MilKris666/DCS-AH-64-KDU-Keyboard-Display-Unit/README.md

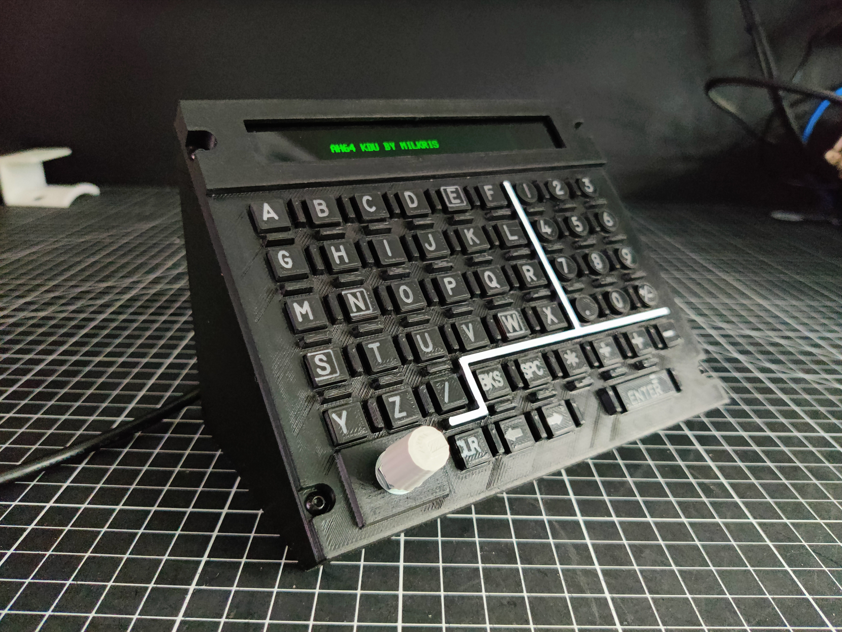
[picture p1: KDU.jpg]


Demo: https://youtube.com/shorts/2huMgZh5P64

Complete CP/G Frontpanel: https://www.youtube.com/shorts/GwC2EZVeXsk

# This is now Arduino-only KDU! No BBI64 board is required!

# The code has been completely redesigned. It constantly checks whether you are in the pilot or co-pilot/gunner position, and the controls are automatically assigned accordingly.

Here is my KDU (Keyboard Display Unit) for the DCS AH-64D Apache. The project includes files for 3D printing, laser engraving of the button labels, and, of course, the Arduino code.

I engraved the labels with a laser, but I've added another version of the buttons where the labels are raised so they can be printed directly with a 3D printer.

I used an Arduino MEGA 2560 and a SSD1322 SPI 256x64 green pixels OLED (4-Wire SPI Interface).

Make sure to use the latest version of DCS-BIOS Skunkworks.

**RTFM** -- read the **How-To.pdf** !!
Download the How-To.pdf to access the links!

**LICENSE:**
Creative Commons Attribution-NonCommercial 4.0 International Public License

**My projects have been downloaded thousands of times in the past. Providing the files and creating a guide is very time-consuming. Since no one is willing to make even a small donation, I have decided to offer the 3D files only for a small fee from now on.** https://cults3d.com/de/modell-3d/gadget/ah-64d-kdu-keyboard-display-unit
