MilKris666/DCS-AH-64-KDU-Keyboard-Display-Unit/KDU2.jpg

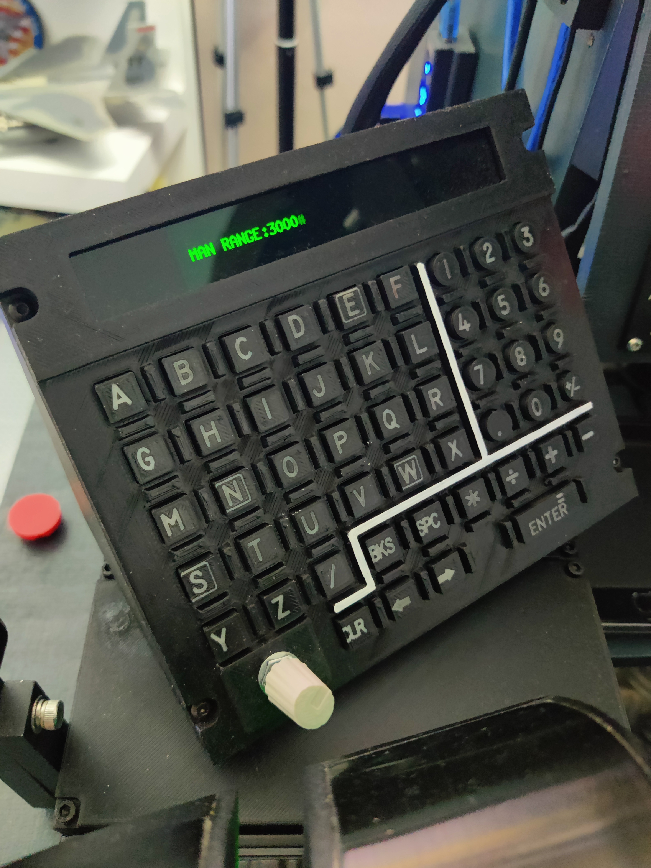
KDU2.jpg
