MilKris666/DCS-AH-64-KDU-Keyboard-Display-Unit/How-To_v6.pdf

# MilKris‘ Keyboard Display Unit (KDU) for the DCS AH64D Apache

This version is for an Arduino-only KDU. No BBI64 board is required!

DISCLAIMER: I’m not a professional maker! It’s not perfect, but it works and I’m fine with the result. Here and there, some filing, drilling, and gluing mightbe necessary...

My projects have been downloaded thousands of times in the past. Providing the files and creating a guide is very time-consuming. Since no one is willing to make even a small donation, I have decided to offer the 3D files only for a small fee from now on. https://cults3d.com/de/modell-3d/gadget/ah-64d-kdu-keyboarddisplay-unit (https://cults3d.com/de/modell-3d/gadget/ah-64d-kdu-keyboard-display-unit)

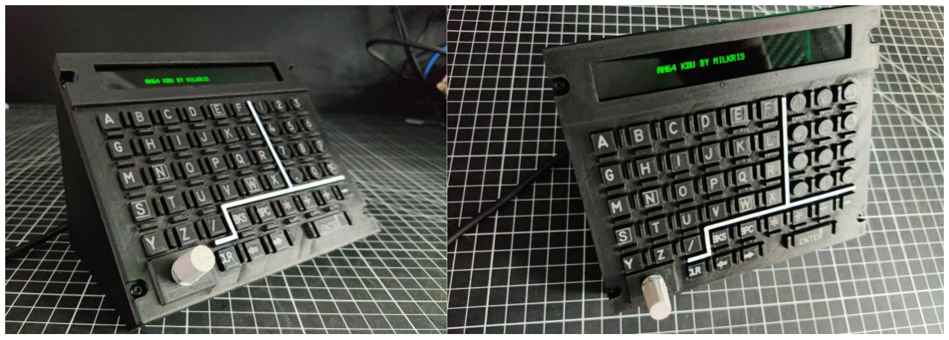
[picture p3: figure]

Here is my KDU (Keyboard Display Unit) for the DCS AH-64D Apache. The project includes files for 3D printing, laser engraving of the button labels, and, of course, the Arduino code.

I engraved the labels with a laser, but I've added another version of the buttons where the labels are raised so they can be printed directly with a 3D printer.

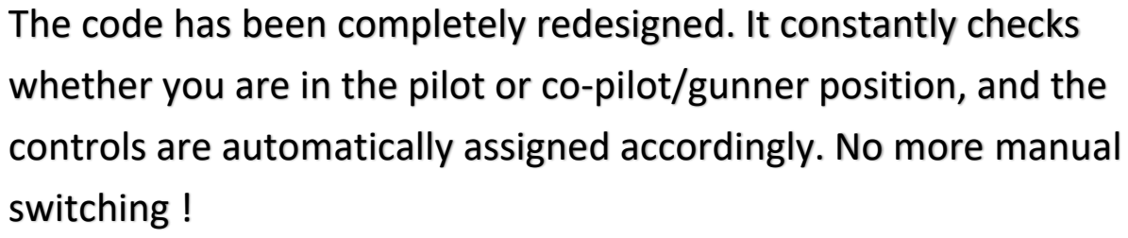
[picture p4: figure]
switching !

## The code has been completely redesigned. It constantly checks whether you are in the pilot or co-pilot/gunner position, and the controls are automatically assigned accordingly. No more manual

You need to flash my code onto an Arduino MEGA. Here is my code: https://github.com/MilKris666/DCS-AH-64-KDU-Keyboard-Display-Unit/blob/main/AH64_KDU_Display_4.ino (https://github.com/MilKris666/DCS-AH-64-KDU-Keyboard-Display-Unit/blob/main/AH64_KDU_Display_4.ino)

If you have no idea how to set up DCS BIOS or upload code to an Arduino, make sure to check out this tutorial by Hornetsnest! https://www.youtube.com/watch?v=ZGoG54vNyyI

# Part list:

50x 6x6x4,3mm Tactile Switches: https://www.amazon.de/Youmile-100PACK-Schalter-Momentan-Tactile/dp/B07XWXV1TS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 (https://www.amazon.de/Youmile-100PACK-Schalter-Momentan-Tactile/dp/B07XWXV1TS)

1x Arduino MEGA 2560 R3 : https://www.amazon.de/Mega-2560-R3-Entwicklungsboard-Kompatibel-Verbessert-Stromversorgung/dp/B0CT8QC1FF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 tQ72-
iIjSGfOJfFYUHD5PuFidfUraswgxqMx9MXz78wgLmiDwant_JbnZ_NY0oDgzMvK7E0oYrZU2uOg3ro92_N WChiTh_zJs_pr4imTFr1d7__L1te9fTxnzzMvXxXB0SGgSXyXJv_Yy8J3jT-kYErX8UN9M0W-VXlGYDmsd6MggJdTmIvVJTZc8do-13Y3U.Af5D_nItbnqtugG2HcTlGeUPVsNloIwUBOOvNPLbqow&dib_tag=se&keywords=arduino+mega +2560&qid=1771854082&sr=8-1 (https://www.amazon.de/Mega-2560-R3-Entwicklungsboard-Kompatibel-Verbessert-Stromversorgung/dp/B0CT8QC1FF)

1x 3.2” SSD1322 SPI 256x64 green pixels OLED (4-Wire SPI Interface): https://www.buydisplay.com/green-3-2-inch-arduino-raspberry-pi-oled-display-module-256x64-spi

1x Potentiometer RV097NS 6mm https://www.amazon.de/s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 (https://www.amazon.de/s?k=RV097NS+Potentiometer&__mk_de_DE=%C3%85M%C3%85%C5%BD%C3%95%C3%91)

Optional if you want backlit lettering
2x green LED Filament:
https://www.amazon.de/LISOCLU-Flexibles-LED-Perlendiode-Lichtzubeh%C3%B6rflexibles/dp/B0DGQ17CBC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 HM9HJDjPLyRUn3fuej3MXhCezRBJt5IEfB8FyzoDpritIx1rgfosUh3JGaqRmsI-P9MpDt8EH45LEnDPwRF5B0AaX2_3dn745xScEQbqDoa2JaSXo75MmcI5gKzkLawPMQL7N3aBiqfc3yb2Bxg3.3z_NiMQb6Ro_yU0_UNk8SAhppodXVby1FKetAXP1tPI&dib_tag=se&keywords=3V%2 BLED-Filament%2B110mm%2BRot%2BGr%C3%BCn%2BBlau%2B2700K%2BFlexible%2BFilamentlampe&qid=1739521114&sr=8-3&th=1 (https://www.amazon.de/LISOCLU-Flexibles-LED-Perlendiode-Lichtzubeh%C3%B6r-flexibles/dp/B0DGQ17CBC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)

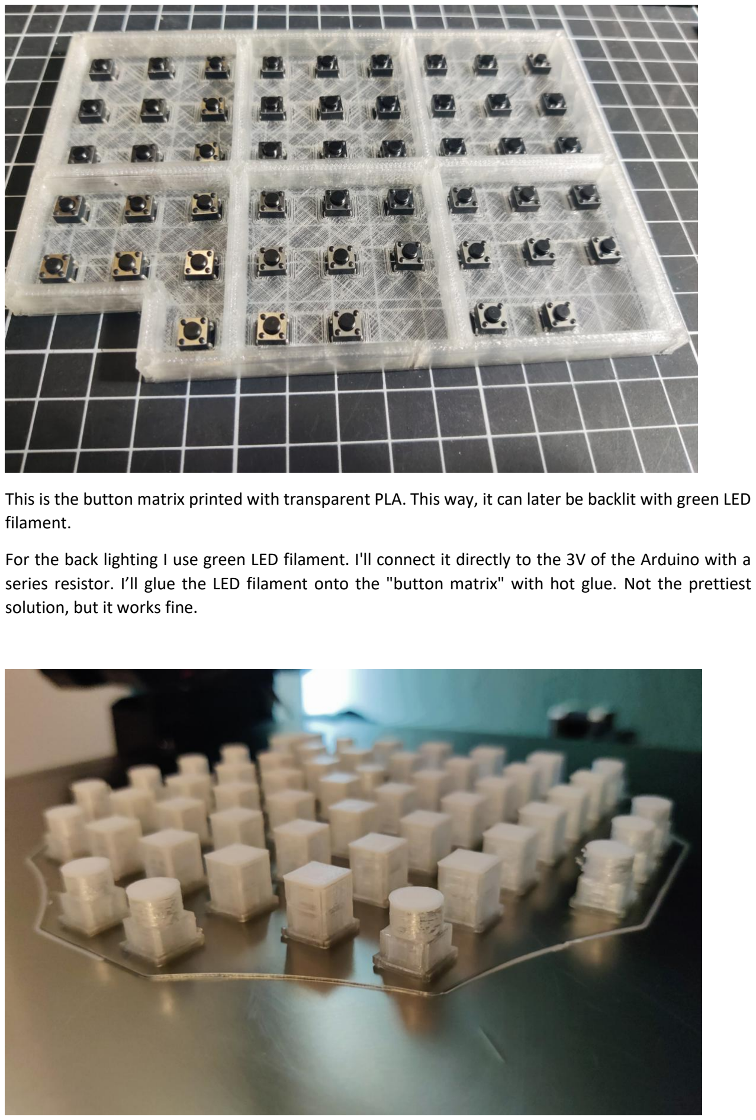
[picture p5: page 3]

This is the button matrix printed with transparent PLA. This way, it can later be backlit with green LED filament.

For the back lighting I use green LED filament. I'll connect it directly to the 3V of the Arduino with a series resistor. I’ll glue the LED filament onto the "button matrix" with hot glue. Not the prettiest solution, but it works fine.

The buttons were also printed with transparent PLA. The top three layers were printed with white PLA, making them ideal for backlighting. The buttons are then spray-painted with black acrylic lacquer from a can and can be engraved with a diode laser.

If laser engraving is not an option for you, you can 3D print the buttons with raised lettering. In this case, you should print the buttons with black PLA and use white PLA only for the top layers.

If you don’t have a dual-extruder 3D printer, you can set up a Post-Process script in you slicer ("Pause at Layer Height") and manually switch the filament.

Alternatively, you can print the buttons entirely in black and carefully paint the lettering white using a white marker (e.g., Edding). To make the finish more durable, you should seal everything with a clear coat.

You'll need to experiment a bit to find out which method works best for you.

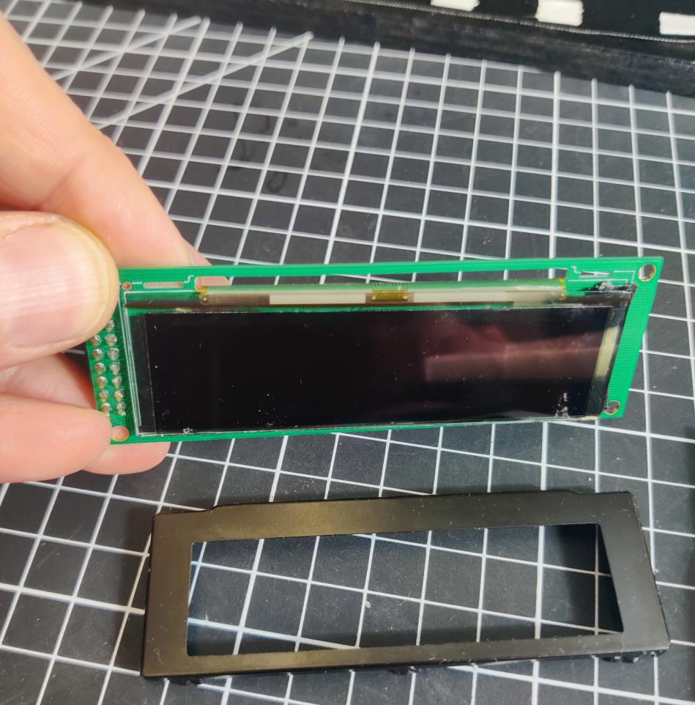
[picture p6: figure]

Remove the frame from the OLED Display.

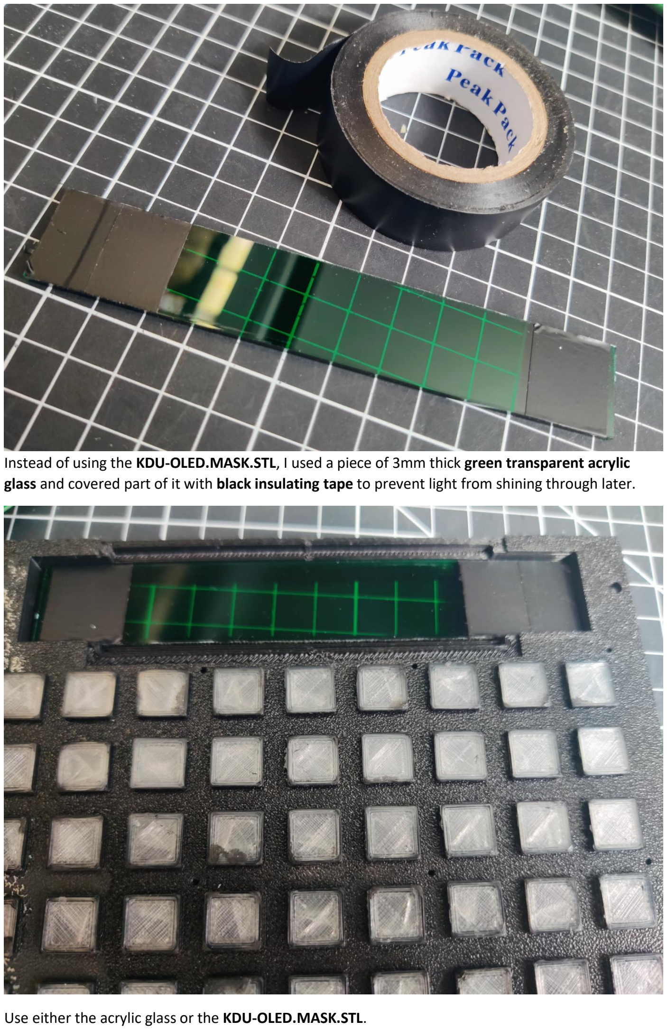
[picture p7: page 5]

Instead of using the KDU-OLED.MASK.STL, I used a piece of 3mm thick green transparent acrylic glass and covered part of it with black insulating tape to prevent light from shining through later.

Use either the acrylic glass or the KDU-OLED.MASK.STL.

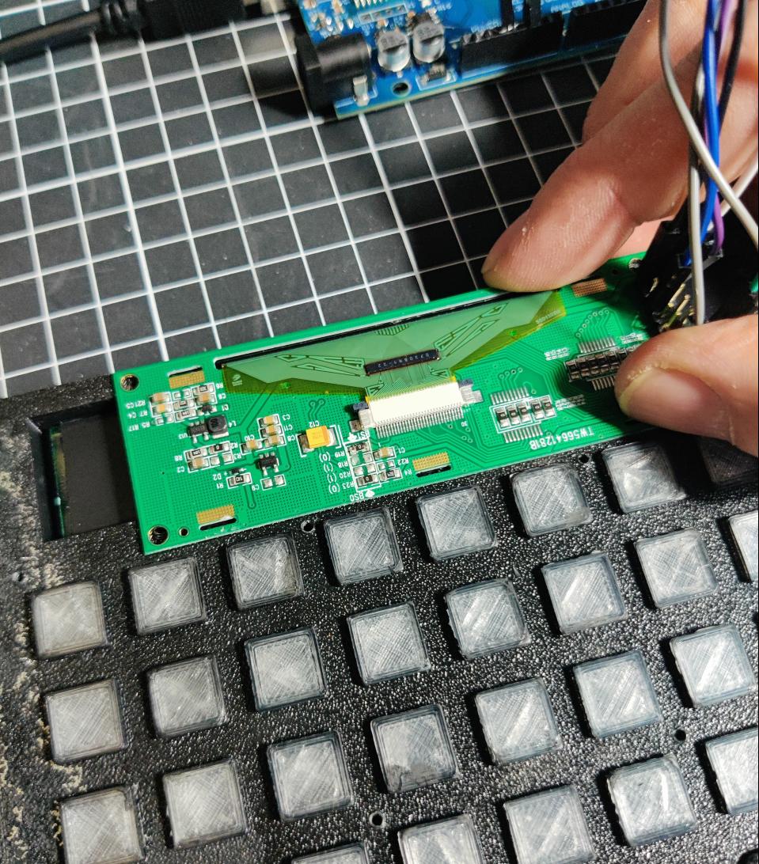
[picture p8: figure]

The OLED is simply inserted and secured by the button matrix. To ensure everything fits together later, the OLED pins need to be bent significantly. Even better, solder the wires instead of using Dupont connectors.

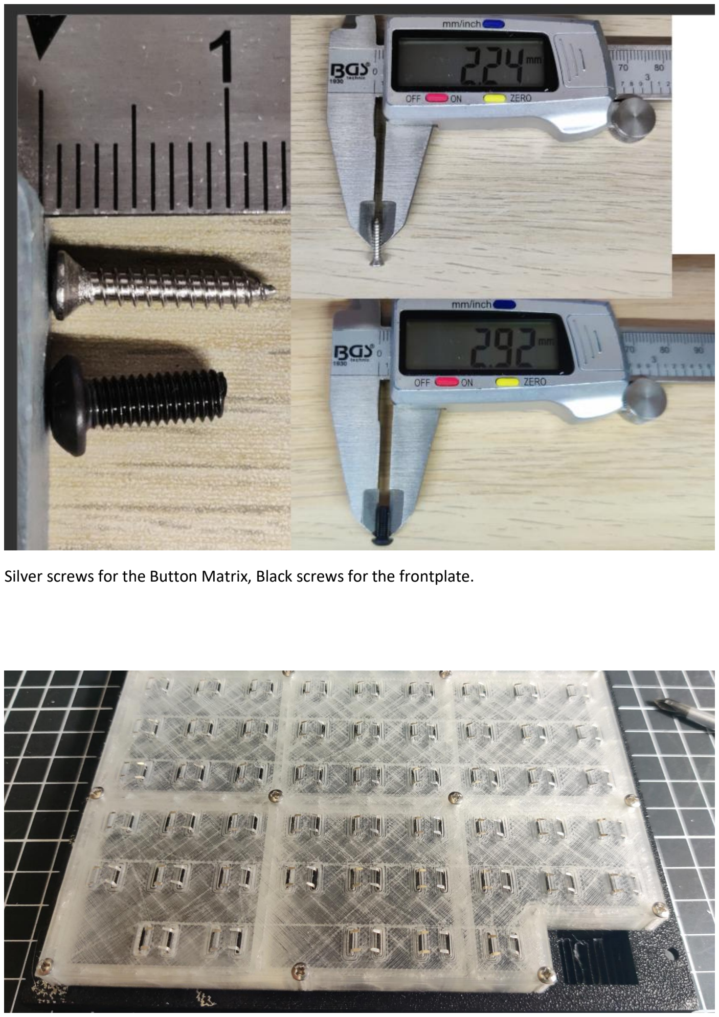
[picture p9: page 7]

Silver screws for the Button Matrix, Black screws for the frontplate.

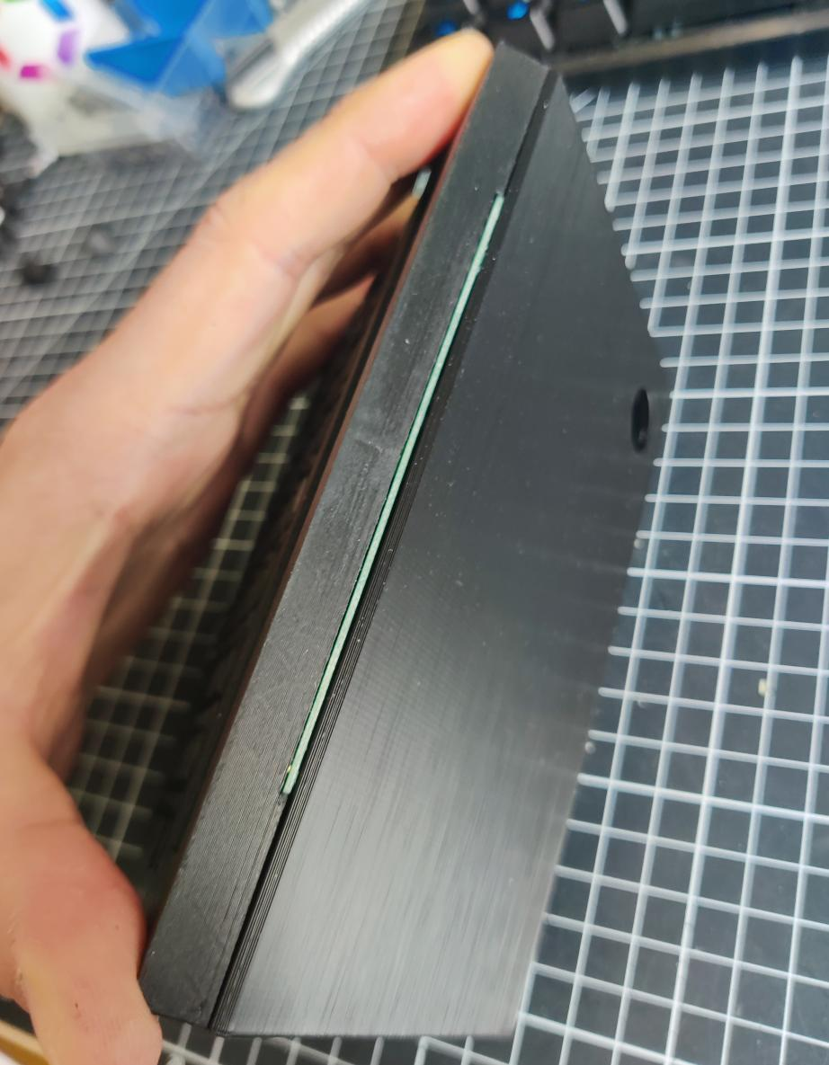
[picture p10: figure]

### Simply connect the OLED display pin by pin to the Arduino, as shown in the diagram. The seven required connections are highlighted with colored dashed lines

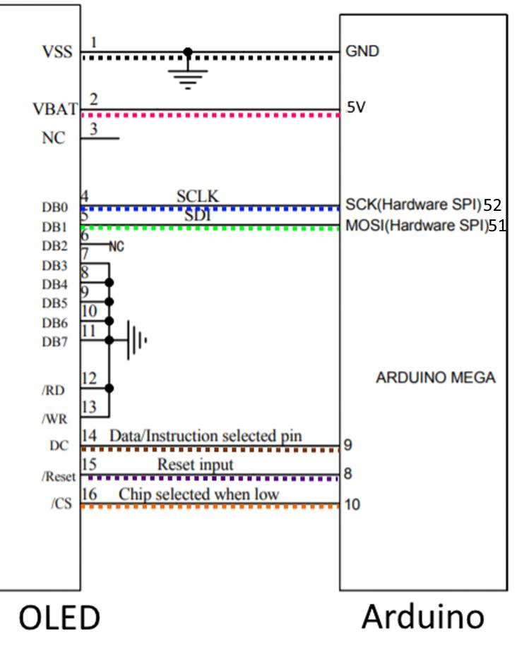
[picture p11: figure]

WARNING! Some SSD1322 OLEDs arrive in I²C mode instead of SPI. To enable SPI mode, the SMD resistors must be configured as shown in the image below:

- R5 (0) → closed
- R6 (1) → open
- R7 (1) → open
- R8 (0) → closed

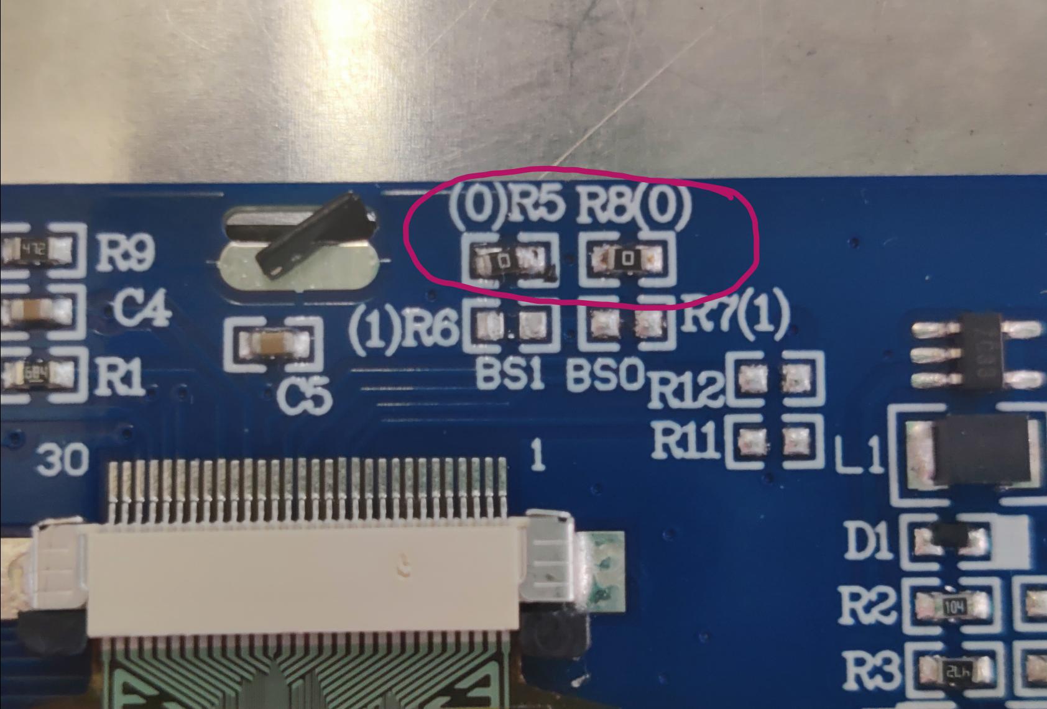
[picture p12: figure]

# WIRING INFO

Display Pin | | Arduino Mega Pin
VCC | | 5V (oder 3.3V je nach Modul!)
GND | | GND
SCK / CLK | 52
MOSI / DIN | 51
CS | 10
DC | 9
RST | 8
Poti | Pin | PLT | CPG
pot_01 | A0 | PLT_KU_BRT | CPG_KU_BRT
Switch | Pin | PLT Controlname | CPG Controlname
switch2_01 | D24 | PLT_KU_0 | CPG_KU_0
switch2_02 | D34 | PLT_KU_1 | CPG_KU_1
switch2_03 | D35 | PLT_KU_2 | CPG_KU_2
switch2_04 | D36 | PLT_KU_3 | CPG_KU_3
switch2_05 | D43 | PLT_KU_4 | CPG_KU_4
switch2_06 | D44 | PLT_KU_5 | CPG_KU_5
switch2_07 | D45 | PLT_KU_6 | CPG_KU_6
switch2_08 | A2 | PLT_KU_7 | CPG_KU_7
switch2_09 | A5 | PLT_KU_8 | CPG_KU_8
switch2_10 | D31 | PLT_KU_9 | CPG_KU_9
switch2_11 | D14 | PLT_KU_A | CPG_KU_A
switch2_12 | A1 | PLT_KU_B | CPG_KU_B
switch2_13 | D12 | PLT_KU_C | CPG_KU_C
switch2_14 | D11 | PLT_KU_D | CPG_KU_D
switch2_15 | D32 | PLT_KU_E | CPG_KU_E
switch2_16 | D33 | PLT_KU_F | CPG_KU_F
switch2_17 | D37 | PLT_KU_G | CPG_KU_G
switch2_18 | D38 | PLT_KU_H | CPG_KU_H
switch2_19 | D39 | PLT_KU_I | CPG_KU_I
switch2_20 | D40 | PLT_KU_J | CPG_KU_J
switch2_21 | D41 | PLT_KU_K | CPG_KU_K
switch2_22 | D42 | PLT_KU_L | CPG_KU_L
switch2_23 | D46 | PLT_KU_M | CPG_KU_M
switch2_24 | D47 | PLT_KU_N | CPG_KU_N

Switch | Pin | PLT Controlname | CPG Controlname
switch2_25 | D48 | PLT_KU_O | CPG_KU_O
switch2_26 | D49 | PLT_KU_P | CPG_KU_P
switch2_27 | A3 | PLT_KU_Q | CPG_KU_Q
switch2_28 | A4 | PLT_KU_R | CPG_KU_R
switch2_29 | D30 | PLT_KU_S | CPG_KU_S
switch2_30 | D29 | PLT_KU_T | CPG_KU_T
switch2_31 | D28 | PLT_KU_U | CPG_KU_U
switch2_32 | D27 | PLT_KU_V | CPG_KU_V
switch2_33 | D26 | PLT_KU_W | CPG_KU_W
switch2_34 | D25 | PLT_KU_X | CPG_KU_X
switch2_35 | A7 | PLT_KU_Y | CPG_KU_Y
switch2_36 | A8 | PLT_KU_Z | CPG_KU_Z
switch2_37 | D18 | PLT_KU_LEFT | CPG_KU_LEFT
switch2_38 | D17 | PLT_KU_RIGHT | CPG_KU_RIGHT
switch2_39 | D7 | PLT_KU_BKS | CPG_KU_BKS
switch2_40 | D19 | PLT_KU_CLR | CPG_KU_CLR
switch2_41 | D4 | PLT_KU_DIV | CPG_KU_DIV
switch2_42 | D23 | PLT_KU_DOT | CPG_KU_DOT
switch2_43 | D16 | PLT_KU_ENT | CPG_KU_ENT
switch2_44 | D2 | PLT_KU_MINUS | CPG_KU_MINUS
switch2_45 | D5 | PLT_KU_MULTI | CPG_KU_MULTI
switch2_46 | D3 | PLT_KU_PLUS | CPG_KU_PLUS
switch2_47 | D22 | PLT_KU_SIGN | CPG_KU_SIGN
switch2_48 | A9 | PLT_KU_SLASH | CPG_KU_SLASH
switch2_49 | D6 | PLT_KU_SPC | CPG_KU_SPC

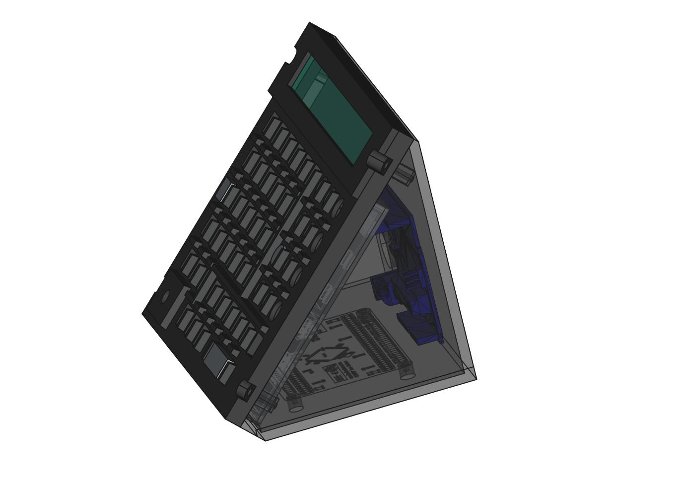
[picture p13: figure]
