MilKris666/DCS-AH-64-KDU-Keyboard-Display-Unit/How-To.pdf

# MilKris‘ Keyboard Display Unit (KDU) for the DCS AH64D Apache

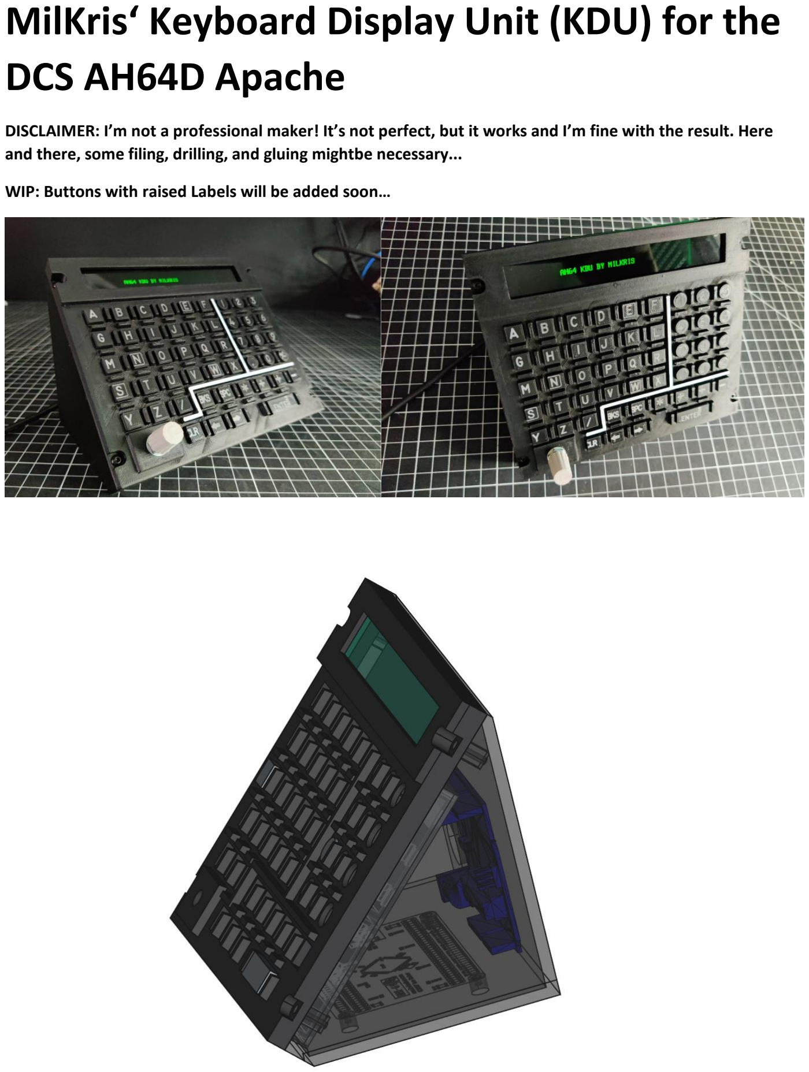
[picture p14: page 1]

DISCLAIMER: I’m not a professional maker! It’s not perfect, but it works and I’m fine with the result. Here and there, some filing, drilling, and gluing mightbe necessary...

WIP: Buttons with raised Labels will be added soon…

You need:

50x 6x6x4,3mm Tactile Switches: https://www.amazon.de/Youmile-100PACK-Schalter-Momentan-Tactile/dp/B07XWXV1TS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 (https://www.amazon.de/Youmile-100PACK-Schalter-Momentan-Tactile/dp/B07XWXV1TS)

1x Arduino UNO: https://www.amazon.de/Entwicklungskarten-Mikrocontrollern-Bingheelektronische-Kompatibel/dp/B0DKX16PJT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 qid=1739455679&sr=8-17 (https://www.amazon.de/Entwicklungskarten-Mikrocontrollern-Binghe-elektronische-Kompatibel/dp/B0DKX16PJT)

1x SSD1322 SPI OLED: https://www.amazon.de/OLED-Display-SSD1322-Grafik-LCD-Modul-Parallel-L%C3%B6tstift-wei%C3%9F/dp/B0DQ52MRX1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 (https://www.amazon.de/OLED-Display-SSD1322-Grafik-LCD-Modul-Parallel-L%C3%B6tstift-wei%C3%9F/dp/B0DQ52MRX1)

1x Rotary Encoder: https://www.amazon.de/Drehgeber-Drehwinkelgeber-Digital-Potentiometer-Encoder/dp/B0B63YN466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 HU2K8SeNbNwpCsJ6Vg5nMULRNwRJ6Uxj7ICXr25UlcgFOb-3piOo0v1sLLtAed3bi3OQrqieZ96s0bh6Isc40fqSFs0EnRit2HuflkEqfBKdsaTWKNQpdv2MtKj7ySbaM5aR N3hzxZqV0DbRGTKGv--0ag832N_qoXJ1pNoslYA7ILRrk8IlrCFuzK9kemtVBpTcHSolBqxikwKYLJnmGnGZsJKrRZmxj8P0noU8vwozXeCNM2uiJgmoJ31JzZGqgbn0GpdiFnrUbR8OdaQ8lCqI34Vcyj PH3kQz2u68BhEH3EJD5XNeCAhPssJlhK9F5KphpeM_ZMFbVpn8pHE8SaS2V0XvOyoZ1dMo.wv43IIVzUWdEnMpqotB_RK5SoSf9bwj2iXBWaIC8Qxs&dib_tag=se&key words=rotary%2Bencoder&qid=1739520345&sprefix=rotary%2B%2Caps%2C103&sr=8-10&th=1 (https://www.amazon.de/Drehgeber-Drehwinkelgeber-Digital-Potentiometer-Encoder/dp/B0B63YN466)

1x Leobodnar BBI64:
https://www.leobodnar.com/shop/index.php?main_page=product_info&products_id=300

Instead of using the BBI64, you can create your own button matrix for the Arduino and extend my code. However, you might need an Arduino MEGA, as the memory could be too small.

2x green LED Filament:

https://www.amazon.de/LISOCLU-Flexibles-LED-Perlendiode-Lichtzubeh%C3%B6rflexibles/dp/B0DGQ17CBC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 HM9HJDjPLyRUn3fuej3MXhCezRBJt5IEfB8FyzoDpritIx1rgfosUh3JGaqRmsI-P9MpDt8EH45LEnDPwRF5B0AaX2_3dn745xScEQbqDoa2JaSXo75MmcI5gKzkLawPMQL7N3aBiqfc3yb2Bxg3.3z_NiMQb6Ro_yU0_UNk8SAhppodXVby1FKetAXP1tPI&dib_tag=se&keywords=3V%2 BLED-Filament%2B110mm%2BRot%2BGr%C3%BCn%2BBlau%2B2700K%2BFlexible%2BFilamentlampe&qid=1739521114&sr=8-3&th=1 (https://www.amazon.de/LISOCLU-Flexibles-LED-Perlendiode-Lichtzubeh%C3%B6r-flexibles/dp/B0DGQ17CBC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)

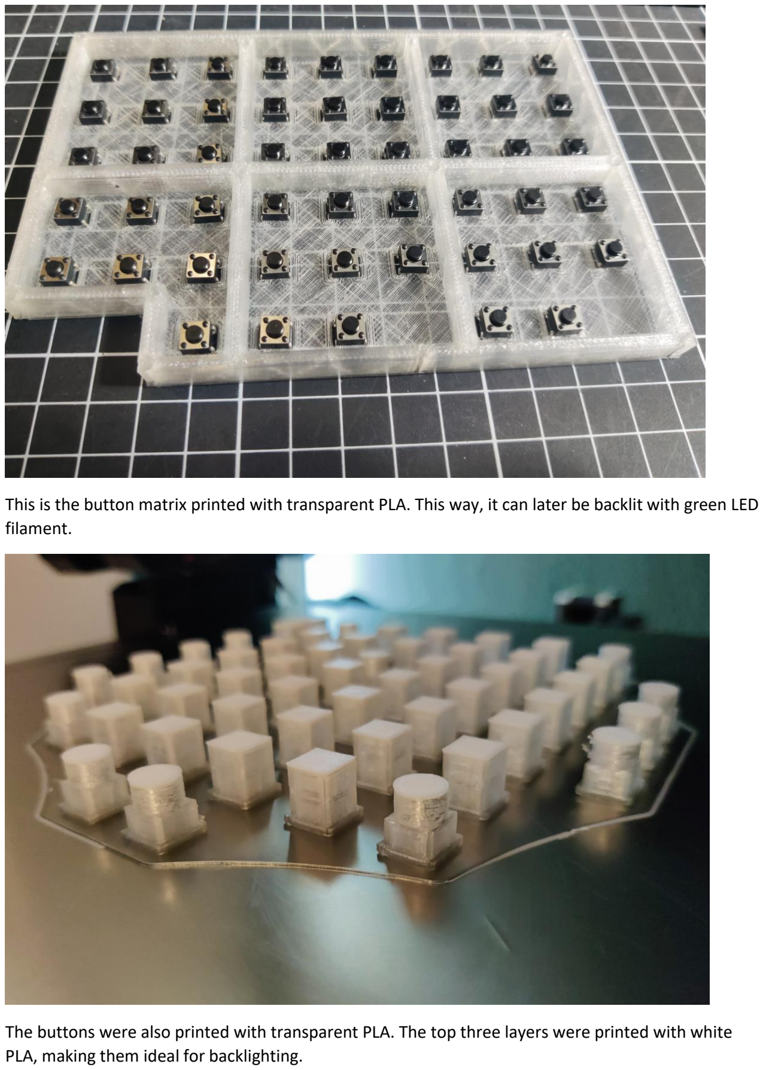
[picture p15: page 3]

This is the button matrix printed with transparent PLA. This way, it can later be backlit with green LED filament.

The buttons were also printed with transparent PLA. The top three layers were printed with white PLA, making them ideal for backlighting.

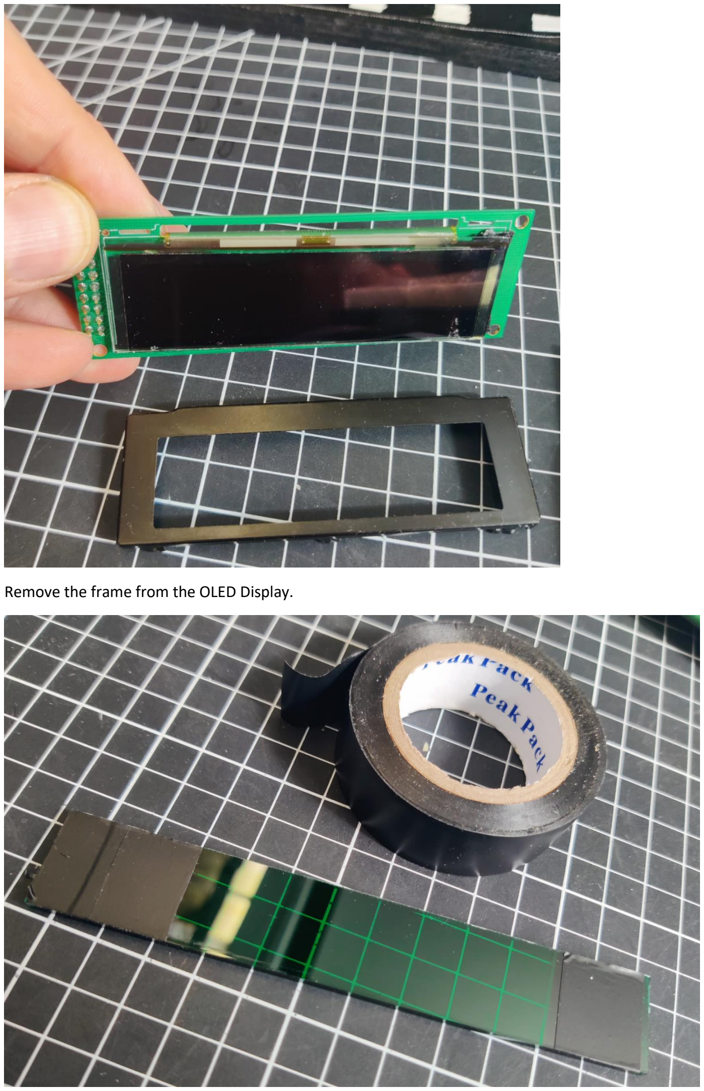
[picture p16: page 4]

Remove the frame from the OLED Display.

Instead of using the KDU-OLED.MASK.STL, I used a piece of green transparent acrylic glass and covered part of it with black insulating tape to prevent light from shining through later.

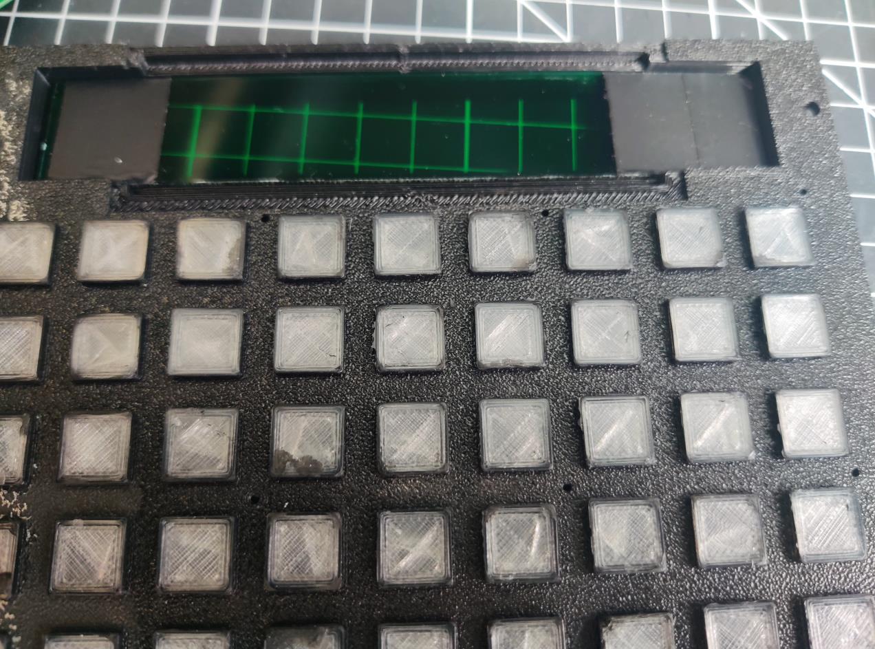
[picture p17: figure]

Use either the acrylic glass or the KDU-OLED.MASK.STL.

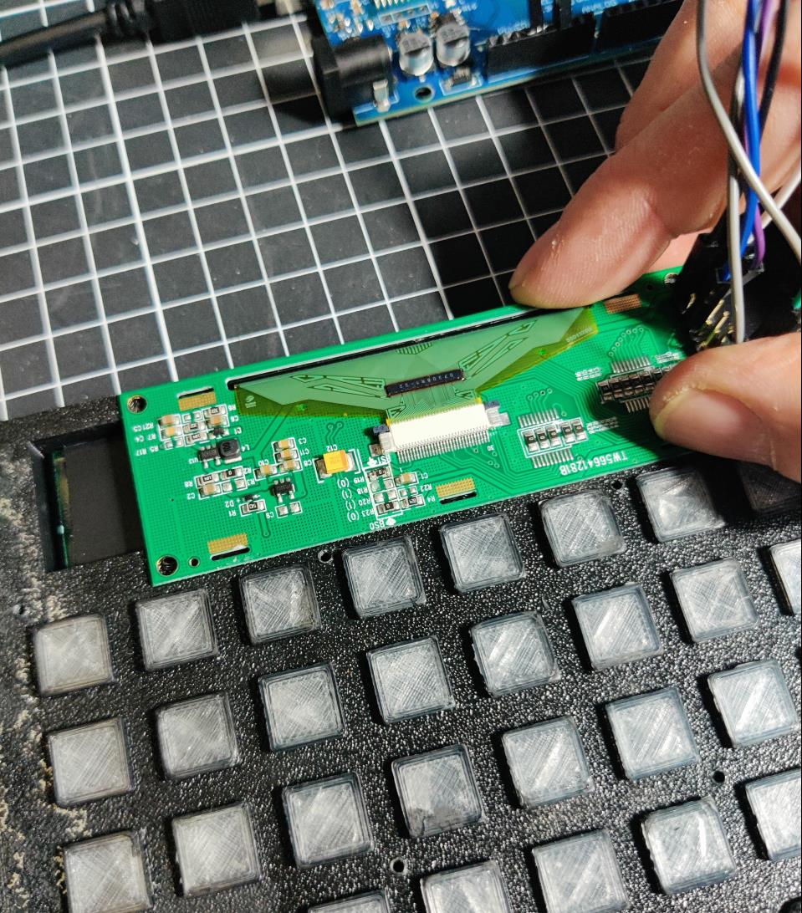
[picture p18: figure]

The OLED is simply inserted and secured by the button matrix. To ensure everything fits together later, the OLED pins need to be bent significantly. Even better, solder the wires instead of using Dupont connectors.

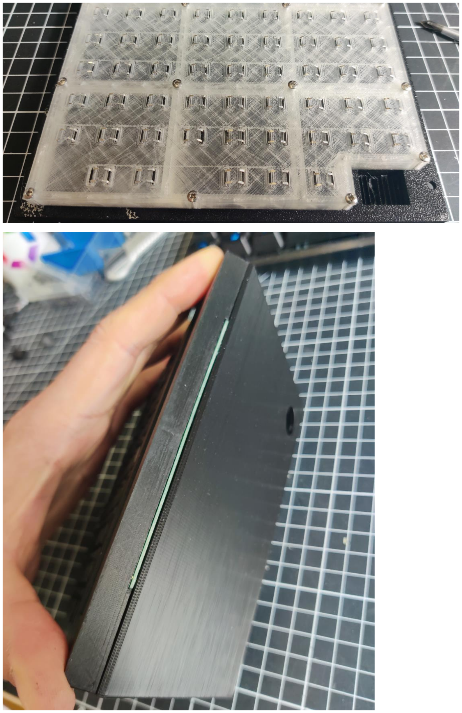
[picture p19: page 7]

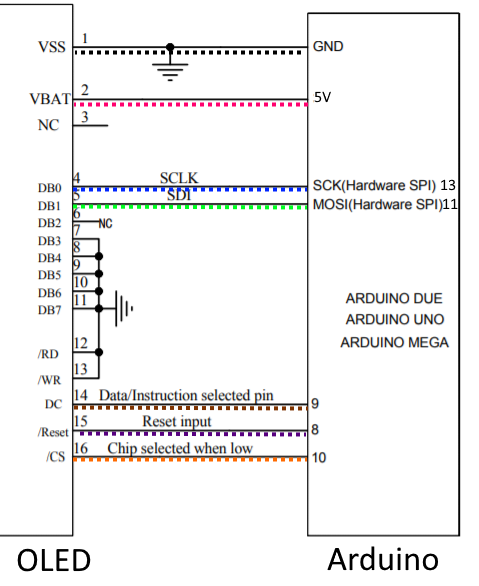
[picture p20: figure]

You can switch the display source from Pilot to CP/Gunner by pressing a button. This button is wired to PIN 7. I integrated this function into the push-button of the rotary encoder for the KU Scratchpad Brightness Knob.

For the lighting (which I haven't installed yet), I’ll use green LED filament. I'll connect it directly to the 3V of the Arduino with a series resistor. I’ll glue the LED filament onto the "button matrix" with hot glue. Not the prettiest solution, but it works fine.
