MilKris666/DCS-AH-64-KDU-Keyboard-Display-Unit/(commit log)

2026-02-23 Update comment on HW SPI pins for clarity
2026-02-24 Update README to clarify Arduino-only KDU feature
    Removed duplicate statement about Arduino-only KDU and adjusted formatting.
2026-02-24 Update README to remove display source switching details
    Removed details about switching display source and button wiring.
2026-08-06 Update README to clarify control assignment feature
    Removed redundant text about switching controls.
